EasySensors/switchBox/pdf/crwdspply.md

# easySwitchBox

#### Wall switch. Arduino IDE compatible (the Atmel ATMega328P) microcontroller and long range HopeRF RFM69\95 radios. Powered with 2 coin cells.

EasySensors (LOGO) created by two long time friends with common passion for creating  electronics and connected things. 

Yury Svirida  image (or Gravatar)  yury.svirida@gmail.com
Evgeny Korenovsky image (or Gravatar)  koreshx@gmail.com

easy Switch Box
easy Switch Box
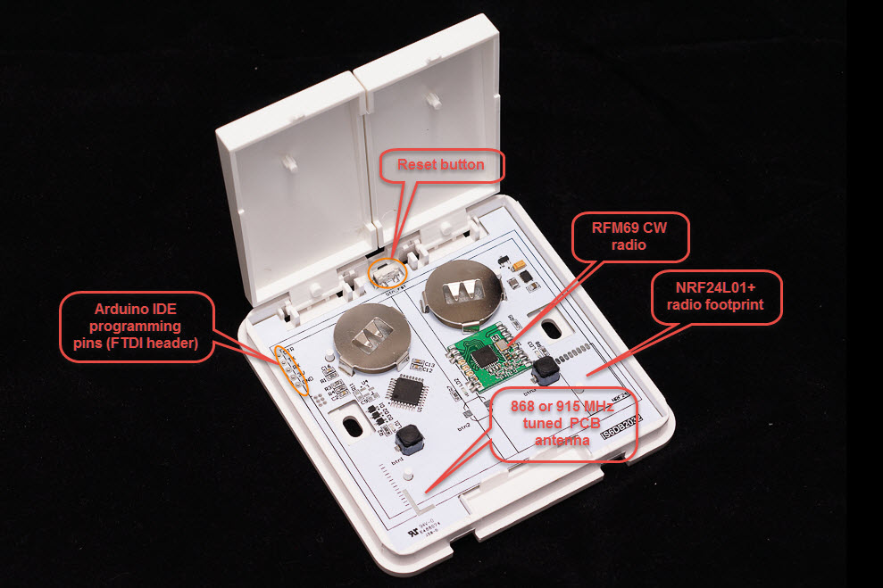
[picture p12: pics/arduino-Switch-Box-23.jpg]
easy Switch Box


### Who Needs It and Why?
It does simple thing – Send on\off signals to any relay, actuator or trigger an event.
Radio used here is RFM95 LORA 433/868/915 MHz or  RFM69-HCW|CW 433/868/915 MHz 
We created the SwitchBox as part of our effort to make nice looking switch, which can be stuck to the wall anywhere with adhesive or screws.  
Long lasting as of couple of years while in daily use.
Secured handshake can be used, backed by ATSHA204A Crypto Authentication chip. 	
### The SwitchBox designed for makers and hobbyists and is easy to program with Arduino IDE.

### Features & Specifications
-	Fully compatible with the Arduino IDE (PRO MINI 8 MG Hz)
-	Radio transceivers: RFM95 LORA 433/868/915 MHz or  RFM69-CW 433/868/915 MHz (low power consumption version) 
-	Onboard Atmel ATSHA204A Crypto Authentication chip makes communication with the Switch Box very secured. ATSHA204A implements secured handshake and if handshake fails the Switch Box will not executing any command sent to it
-	Programming header is FTDI, TTL Serial. For programming you need to have USB TTL Serial – FTDI adaptor
-	Compatible with all RFM 69 \ 95 compatible open source libraries available
-	Onboard tuned PCB  antenna
-	Each button have LED for message delivery confirmation
-	Battery connector: 2 x CR2032
-	Reverse polarity protection
-	High efficient power converter 
-	Long run soft touch buttons

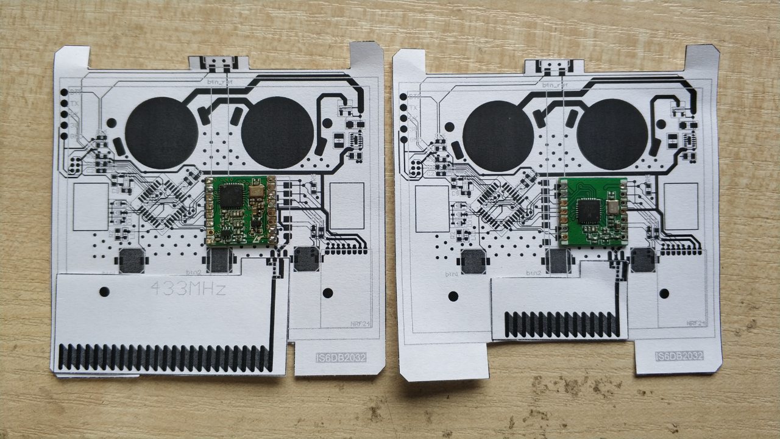
[picture p13: pics/proto2.jpg]

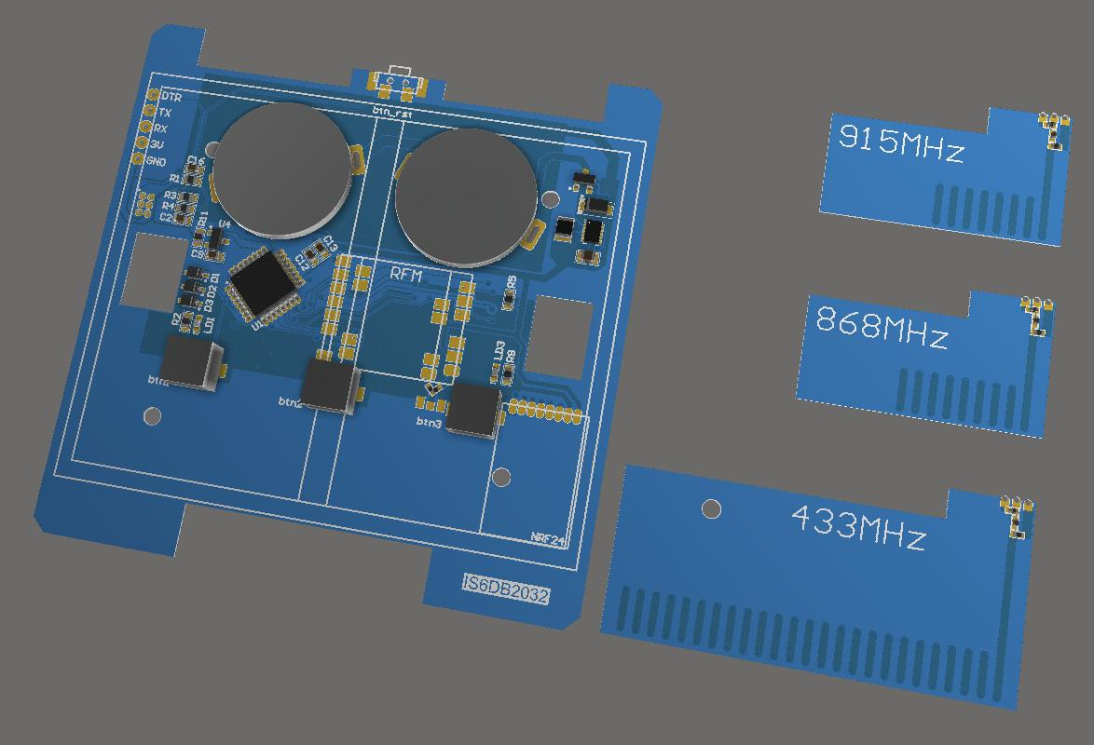
[picture p14: pics/proto1.jpg]

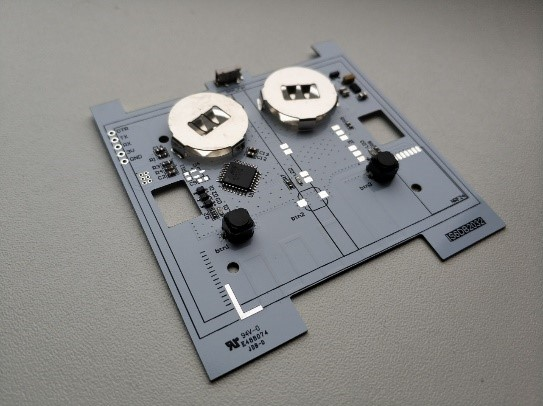
[picture p15: pics/proto3.jpg]

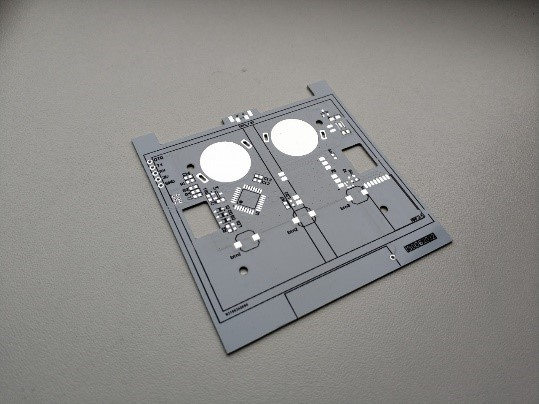
[picture p16: pics/proto4.jpg]

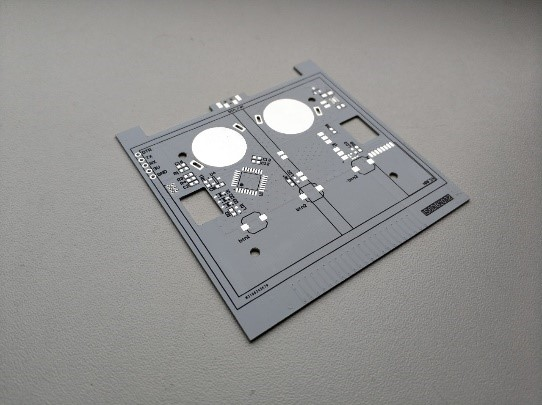
[picture p17: pics/proto5.jpg]


### Challenges
The wide variety of the frequencies could present an additional challenge.
The Switchbox antenna design is based on the successful TI design.
These proven designs reduces the challenges, but the antennas itself shares a lot of the “bench testing” to achieve maximum range. Sometimes it is very much time consuming because it is enclosure and body finger\palm dependent.

### Antenna resonance impedance tuning. 
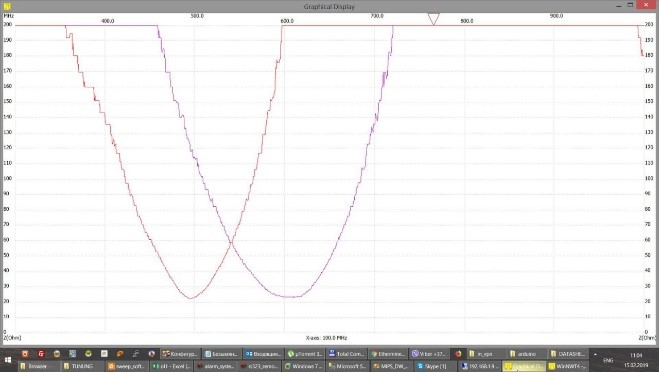
[picture p18: pics/protoTune.jpg]

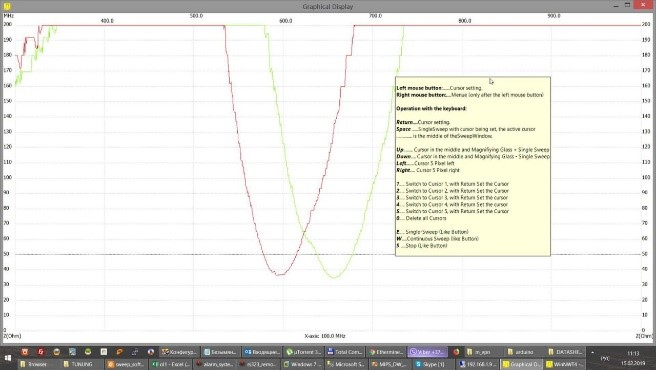
[picture p19: pics/protoTune2.jpg]

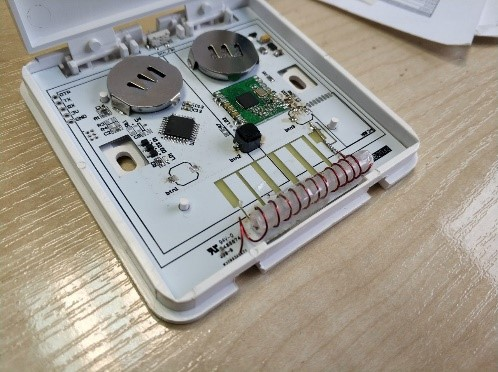
[picture p20: pics/protoTune3.jpg]


### Antenna SWR  matching. 
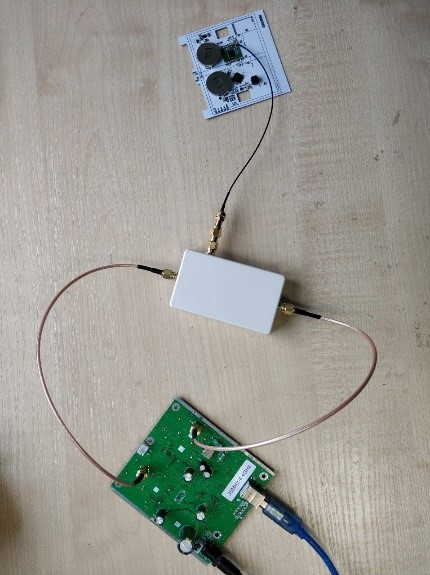
[picture p21: pics/protoTuneSWR.jpg]

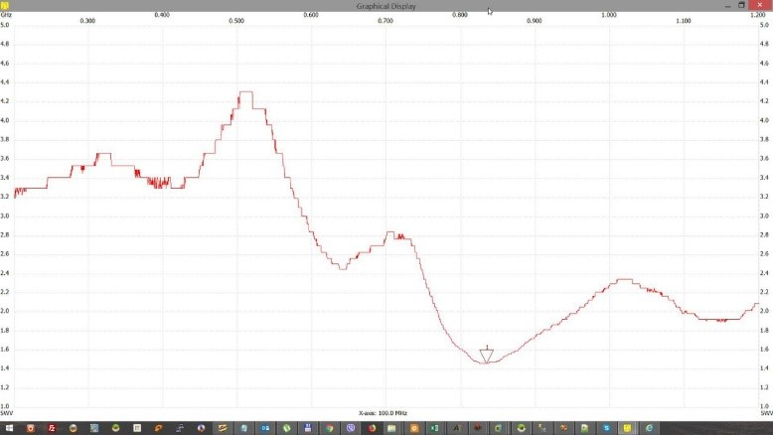
[picture p22: pics/protoTuneSWR2.jpg]
