EasySensors/switchBox/pics/5uA_drain_current.jpg

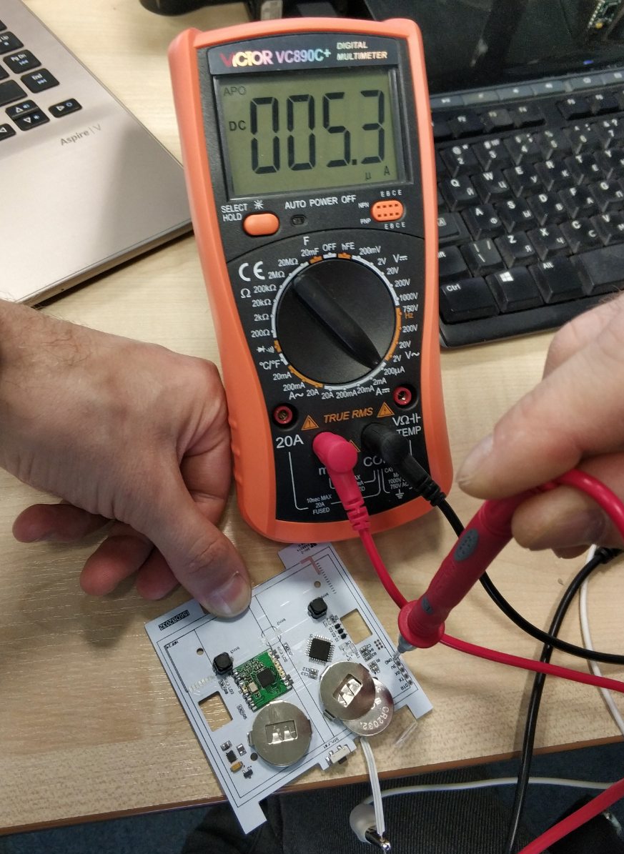
pics/5uA_drain_current.jpg
