EasySensors/switchBox/pics/arduino-Switch-Box-1HD.jpg

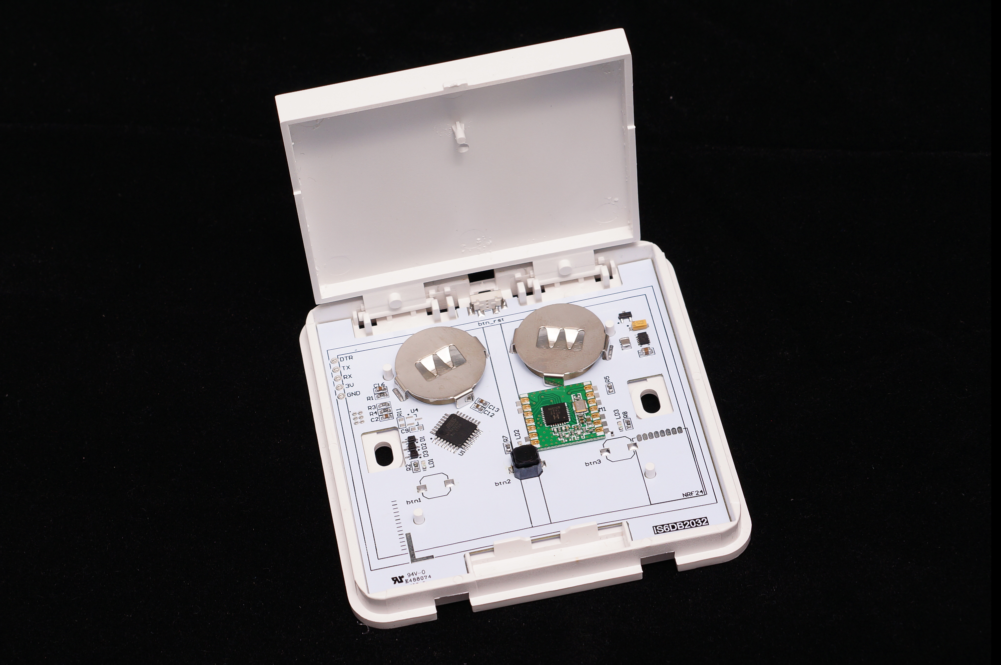
pics/arduino-Switch-Box-1HD.jpg
