EasySensors/switchBox/pics/arduino-Switch-Box-11cr.jpg

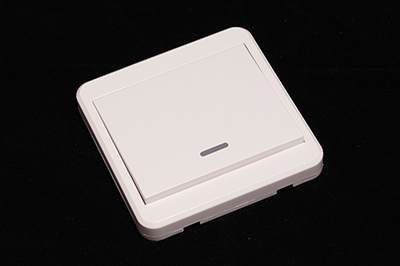
pics/arduino-Switch-Box-11cr.jpg
