EasySensors/switchBox/pics/easySwitchBox1.jpg

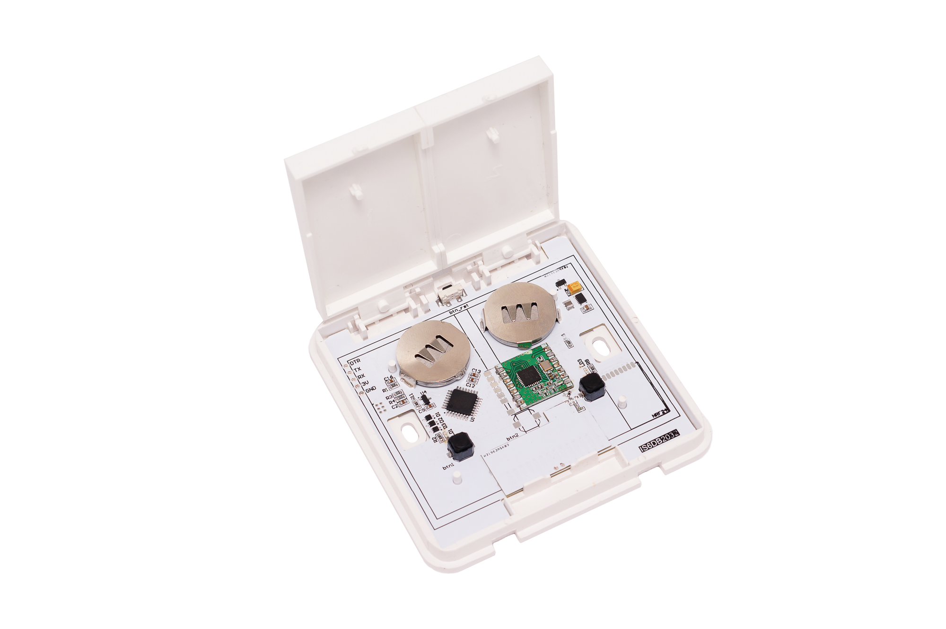
pics/easySwitchBox1.jpg
