EasySensors/switchBox/pics/easySwitchBox1_cr.jpg

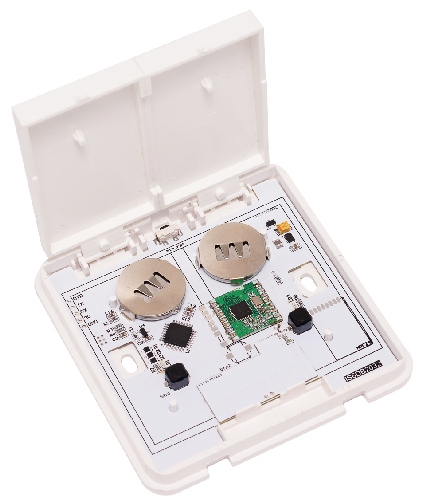
pics/easySwitchBox1_cr.jpg
