EasySensors/switchBox/pics/easySwitchBox2.jpg

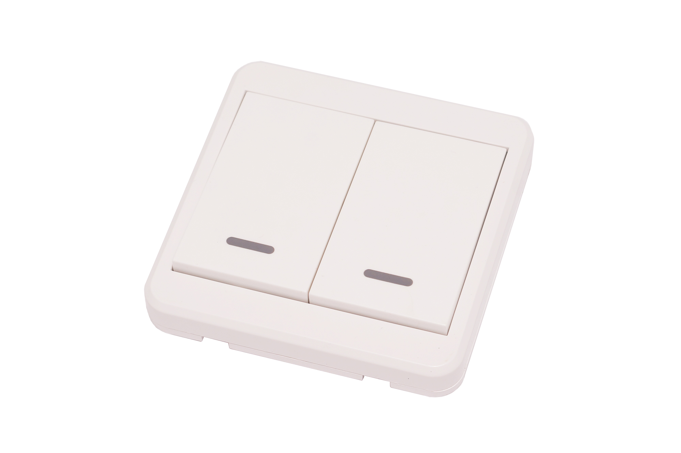
pics/easySwitchBox2.jpg
