EasySensors/switchBox/pics/easySwitchBox7.jpg

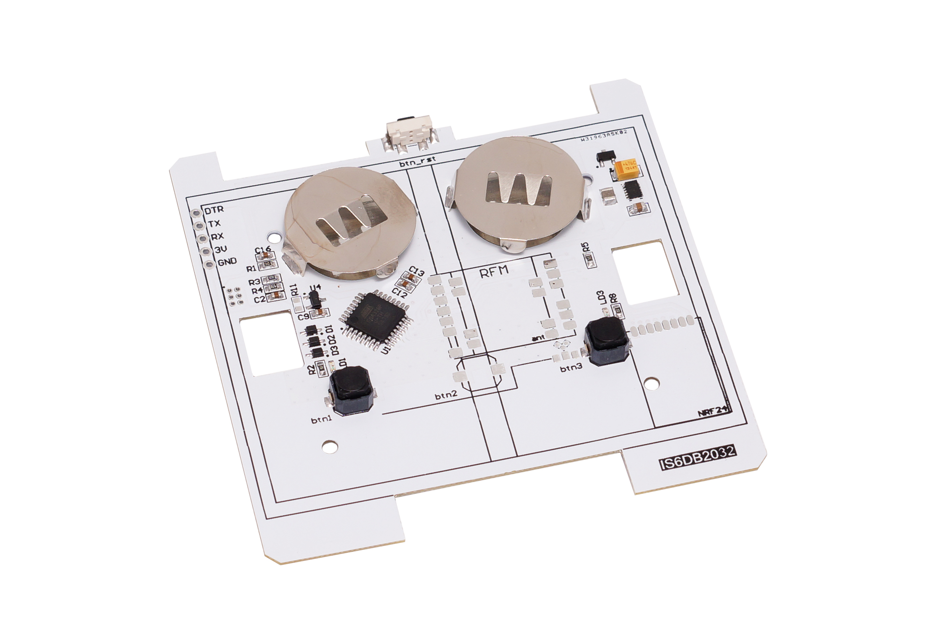
pics/easySwitchBox7.jpg
