EasySensors/switchBox/pics/pinuot.jpg

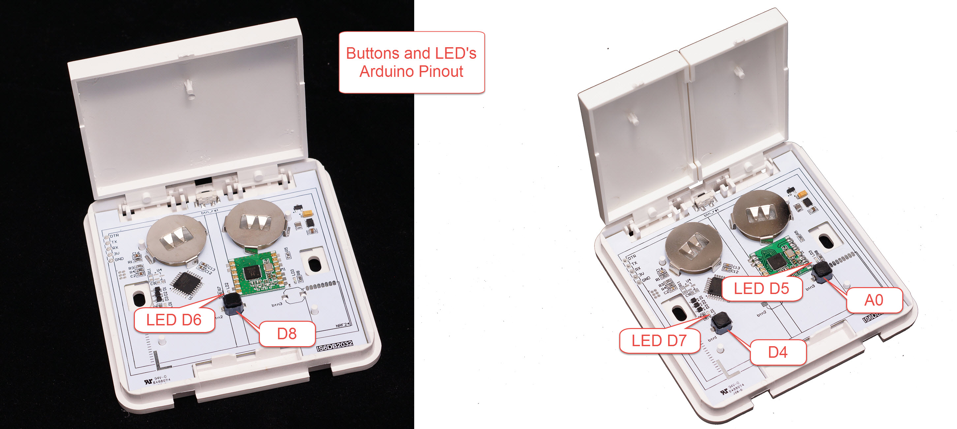
pics/pinuot.jpg
