EasySensors/switchBox/pics/replace.jpg

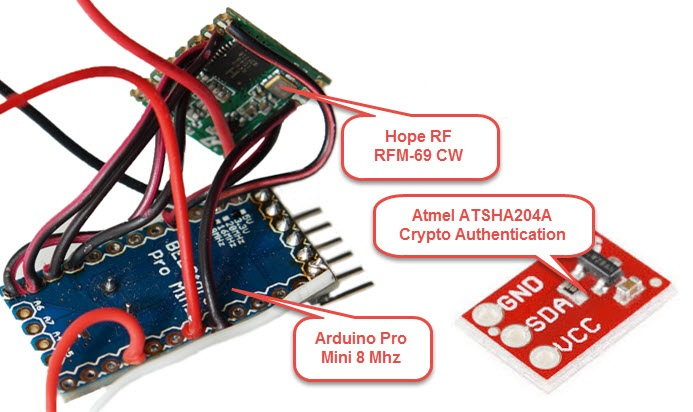
pics/replace.jpg
