EasySensors/switchBox/pics/SwitchNode1.jpg

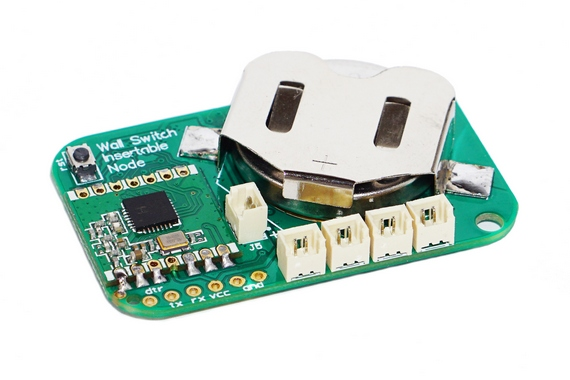
pics/SwitchNode1.jpg
