EasySensors/switchBox/pics/protoTune1.jpg

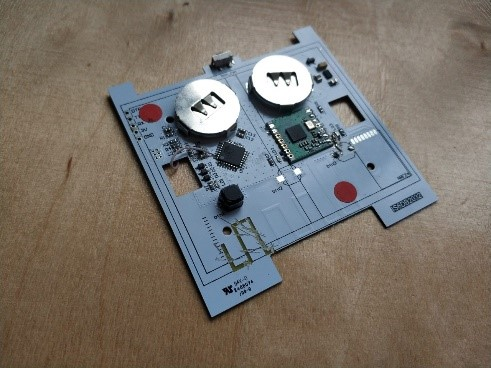
pics/protoTune1.jpg
