EasySensors/switchBox/pics/protoTune4.jpg

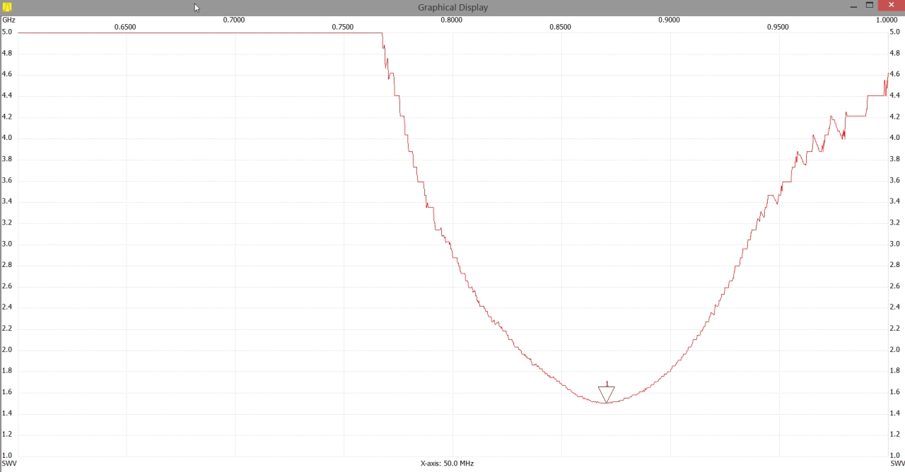
pics/protoTune4.jpg
