EasySensors/switchBox/(threads)

Thread 1 (2019-07-31):

Schematic

doublec4, 2019-07-31:
Hello, I would love to see the schematic on this please. It would really help me with a project I have trying to incorporate the ATMEGA and the RFM69 please. Thank you!

yurysvirida, 2019-07-31:
it is here
https://github.com/EasySensors/switchBox/blob/master/pdf/switch_box_1542303111.pdf

nishu4288, 2019-12-18:
Great Project. Please Provide Footprint for replacing RFM radios with **NRF24L01+ 2.4 GHz** radio As mentioned.
Thank You

j45p41, 2020-12-14:
Hi,

I have purchased your product on Tindie.com and waiting for it to arrive. I was wondering if you could tell me why you have the diodes going across the buttons? I am testing a similar circuit and find that after many repeated operations the arduino hangs. Is this the purpose for your diodes? Thanks!

yurysvirida, 2020-12-17:
> diodes going across the buttons?

The diodes are for using multiple buttons with one interrupt pin shared among them. should not be related to freezing.

Thread 3 (2020-03-04):

Example for TheThingsNetwork

rgm3, 2020-03-04:
Do you have any examples for usage with TheThingsNetwork?

reivis, 2021-12-19:
Is there someone who did it with TTN? Still stuck on it.

yurysvirida, 2021-12-21:
Hi,

There is no code example so far of the switch. But please check this project as it may give you some hints.

https://myiq.de/gitea/LanMarc77/ButtonSizedNodeLoRaWAN

Let me know if it is doing something similar to what you need in TTN functionality.

Thread 4 (2021-08-02):

ID of node

phaltness, 2021-08-02:
Hello
I have purchased few switchBosex on Tindie.com and I have question about 433 Lora revision:
is it assigning random node ID - or it's hardcoded with example sketch = 166 and node ID is not unique for all samples from manufacturing.

Waiting for an answer.
Sincerely, Pavel Nesterenko. Sowillo dev.

yurysvirida, 2021-08-02:
Hello,

 the id# is hard-coded.  you can check the github.com page in the link

https://github.com/EasySensors/switchBox/blob/master/EasySwitchBoxMySensors.ino

line 31

comment line 31 out to assign random # from the controller side.

best regards,
Yury

On Mon., Aug. 2, 2021, 20:40 Pavel Nesterenko, ***@***.***>
wrote:

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

Thread 5 (2024-07-31):

Plastic case design files

Bibernull, 2024-07-31:
Hi,

Are the design files for the plastic enclosure available somewhere?

Thanks

yurysvirida, 2024-07-31:
you can buy it from taobao.com
