EasySensors/switchBox/switch_box_schematics.pdf

# CPU&RADIO

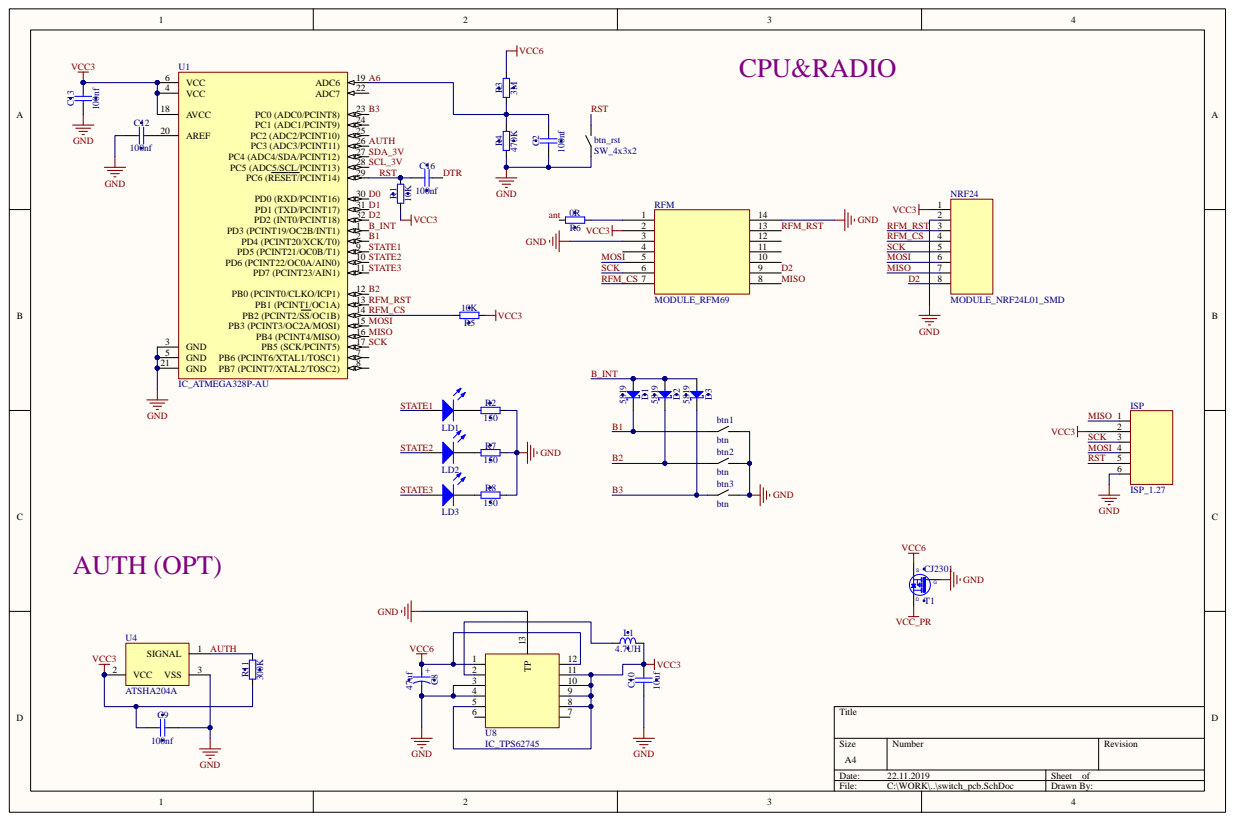
[picture p35: page 1]
