EasySensors/switchBox/(commit log)

2017-05-29 Battery capacity reporting 0% level correction
    2V = 0%
2017-10-12 MySensors 2.2 drivers
    sleep() instead of wait()
    #define MY_RFM69_NEW_DRIVER
2017-11-08 ftdi poweroption
2017-11-16 rfm reset and different relay adreses per JST conn
    relayNodeID
    relayChildID
    set Pin 9 to high impedance after setup
2018-01-28 noInterrupts(); in _flash.....
    /* Send JDEC to sleep
    * all of _flash.initialize(); _flash.sleep(); and _flash.wakeup();
    * need to be wrapped with noInterrupts(); - interrupts();
    */
2018-09-01 This is actual code
    based on the switchNode.ino code
2018-12-01 1-2-3 buttons selection added
    //#define ONE_BUTTON_SWITCH
    //#define TWO_BUTTONS_SWITCH
    #define THREE_BUTTON_SWITCH // all buttons will work
2019-03-31 LoRa radio Defines
    blink LED's on the boot
    wait 2.5 seconds for ack . useful for lora radios
2020-09-07 If Voltage below 5.6 Volts then halt boot process. send battery report after button message sent.
