EasySensors/switchBox/(notices)

Notices in the files:
GatewaySerialMySensors.ino:
modify it under the terms of the GNU General Public License
MoteinoGW.ino:
Copyright Felix Rusu 2016, http://www.LowPowerLab.com/contact
Public License as published by the Free Software
